Robino525/Cast-Concrete-Rocket-Nozzle/Photos/closeup_noWater.jpg

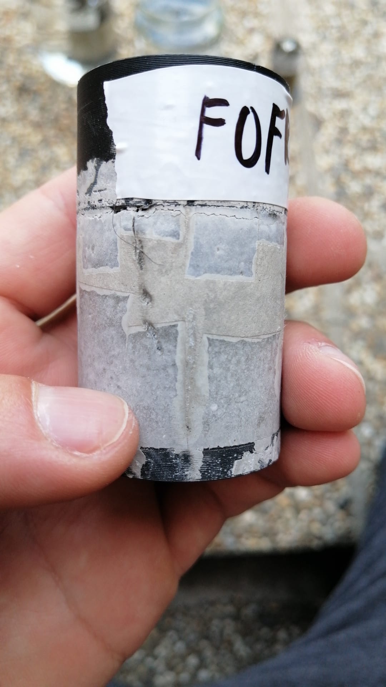
Photos/closeup_noWater.jpg
