Robino525/Cast-Concrete-Rocket-Nozzle/Photos/comparison.jpg

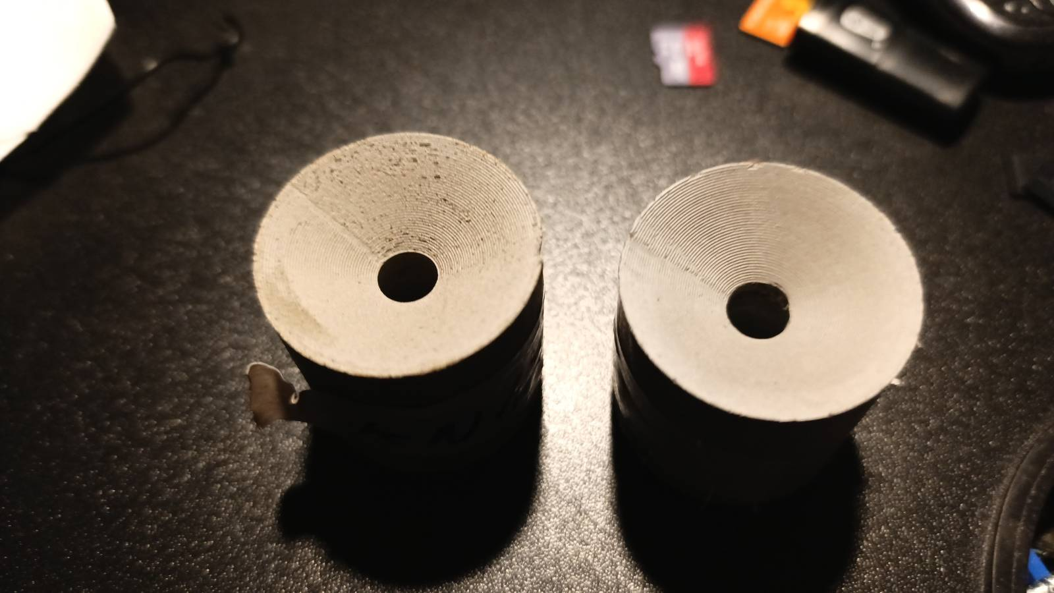
Photos/comparison.jpg
