Robino525/Cast-Concrete-Rocket-Nozzle/Photos/finished.jpg

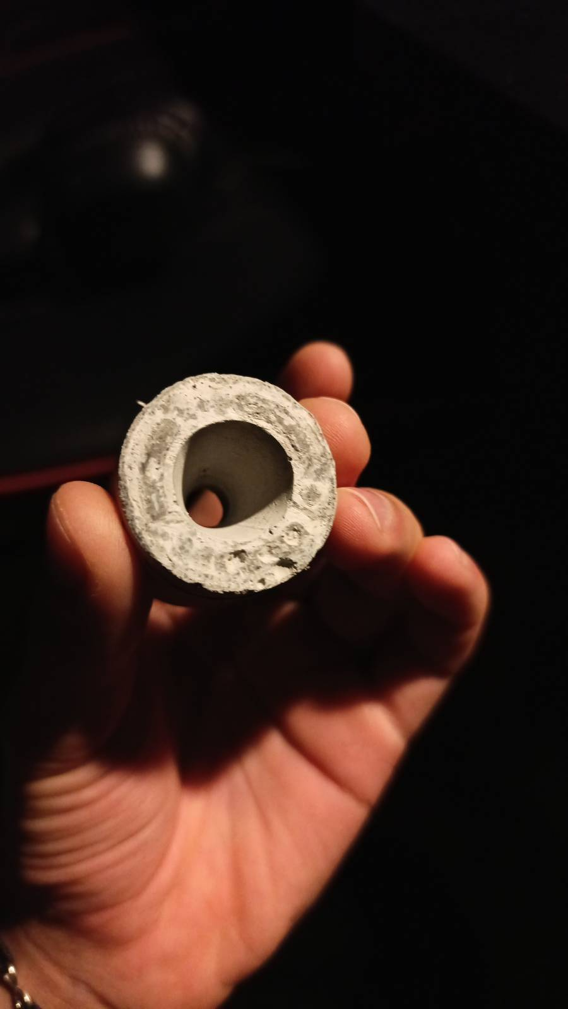
Photos/finished.jpg
