Robino525/Cast-Concrete-Rocket-Nozzle/Photos/liquid_separator.jpg

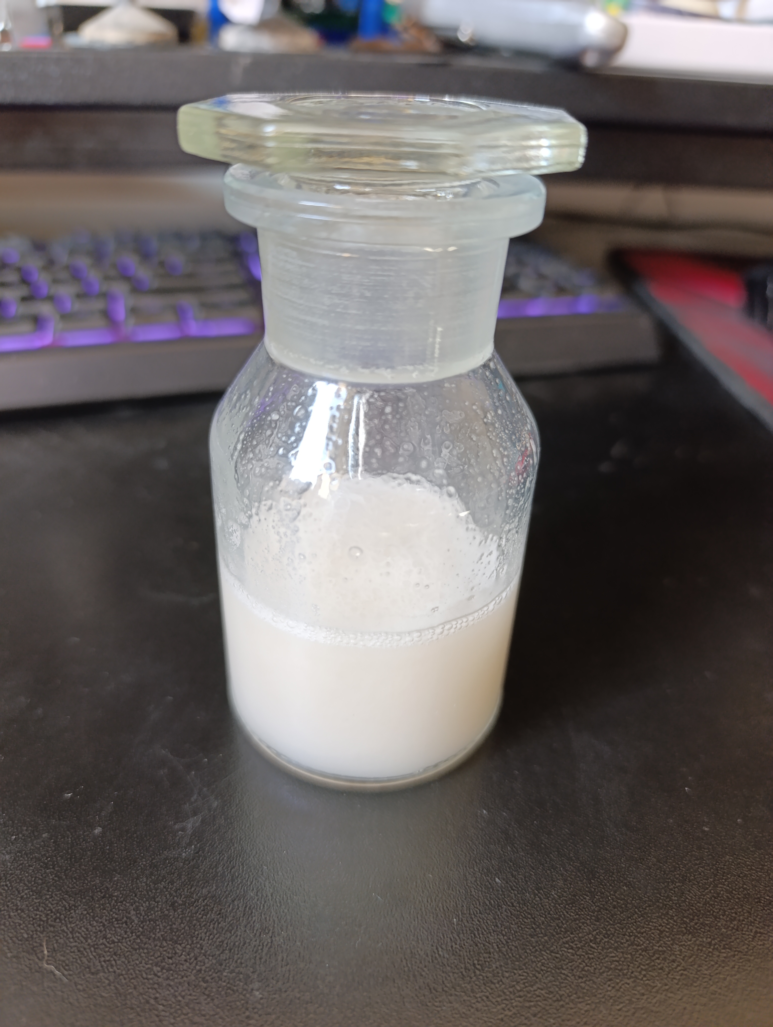
Photos/liquid_separator.jpg
