Robino525/Cast-Concrete-Rocket-Nozzle/Photos/used_mix.jpg

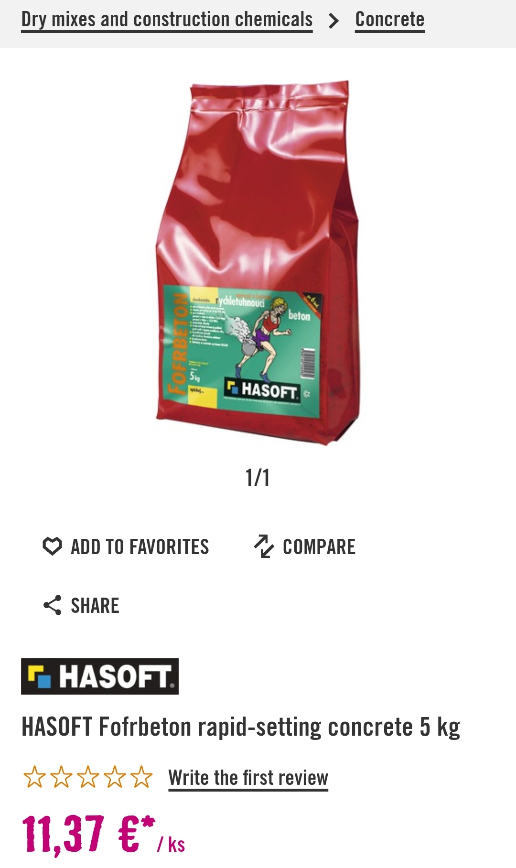
Photos/used_mix.jpg
