Robino525/Cast-Concrete-Rocket-Nozzle/Photos/water_enhanced_solidifying.jpg

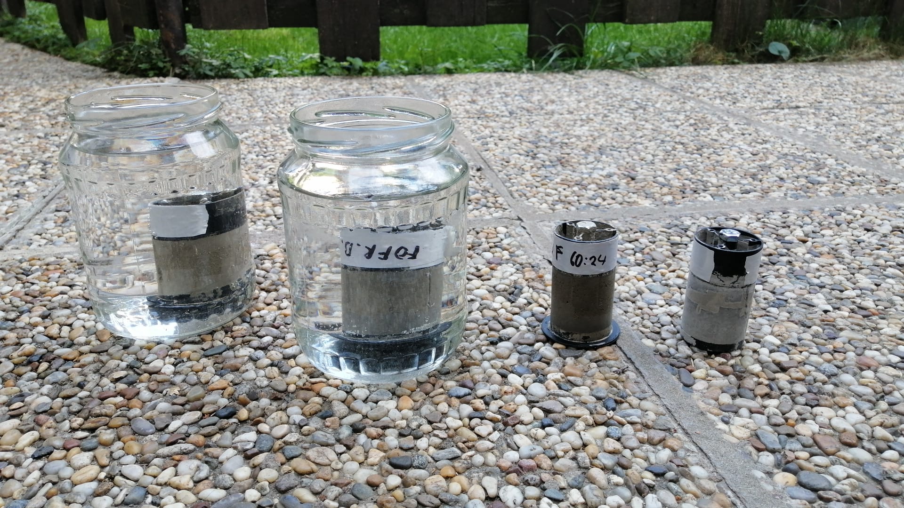
Photos/water_enhanced_solidifying.jpg
