Robino525/Cast-Concrete-Rocket-Nozzle/STL/rocket mottor_34_tube.stl

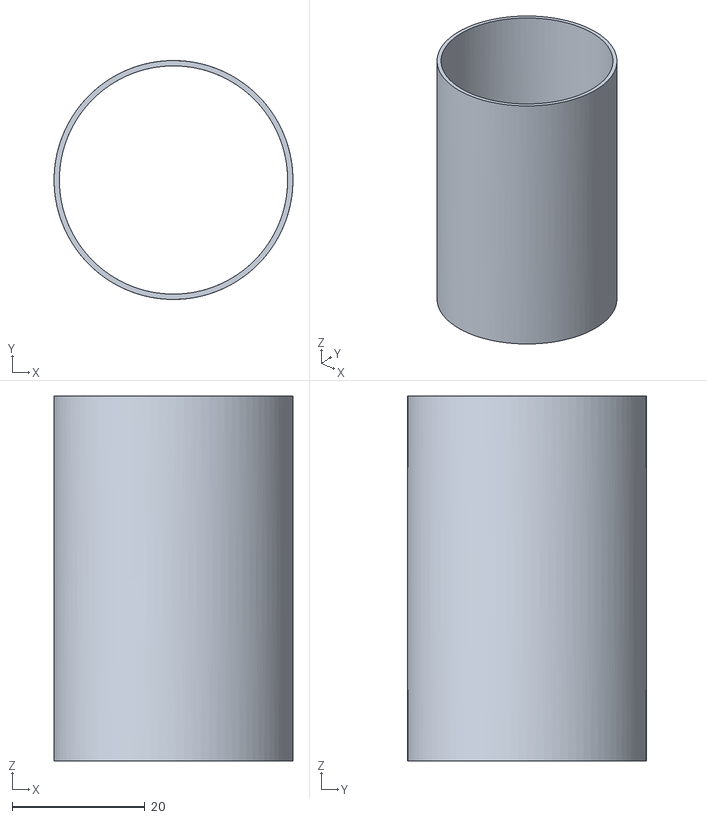
[picture p12: CAD file, 2026-09-25]
STL/rocket mottor_34_tube.stl
36.0 x 36.0 x 55.0
