Robino525/Cast-Concrete-Rocket-Nozzle/STL/rocket mottor_34_bottom.stl

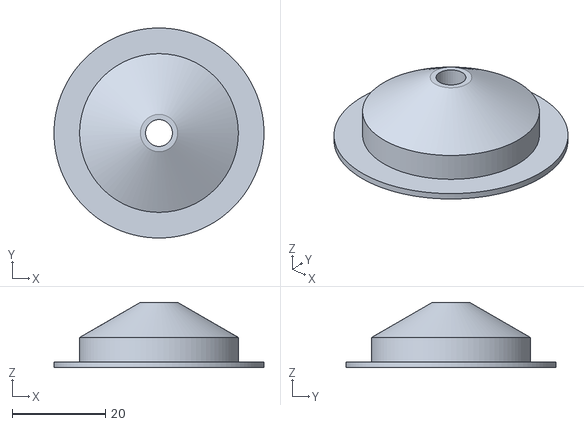
[picture p13: CAD file, 2026-09-25]
STL/rocket mottor_34_bottom.stl
45.0 x 45.0 x 14.0
