Robino525/Cast-Concrete-Rocket-Nozzle/STL/rocket mottor_34_TOP_V3.stl

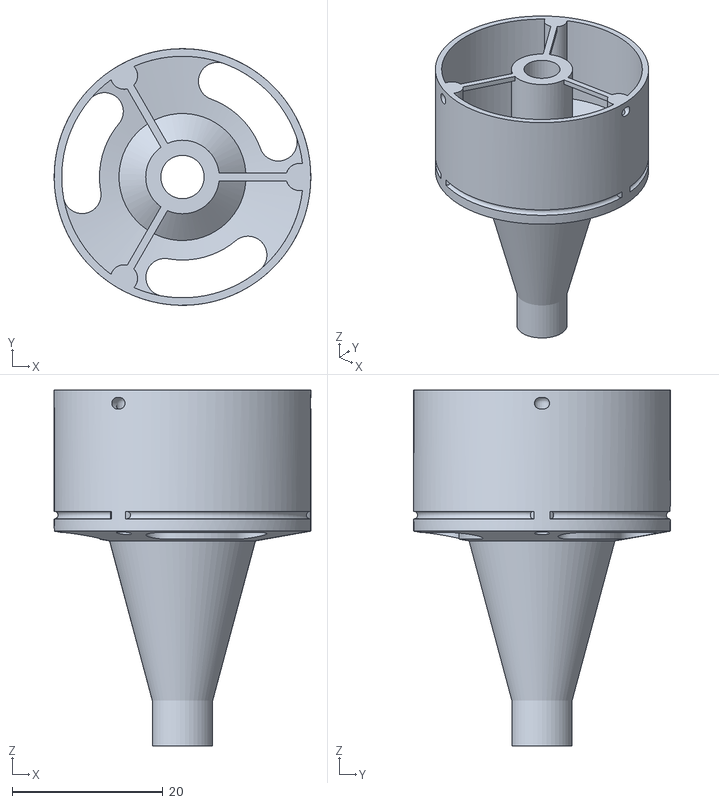
[picture p14: CAD file, 2026-09-25]
STL/rocket mottor_34_TOP_V3.stl
34.0 x 34.0 x 47.2
